spring-2026-mecha11/Course_Proj_Final/docs/doxygen/completed-assembly.png

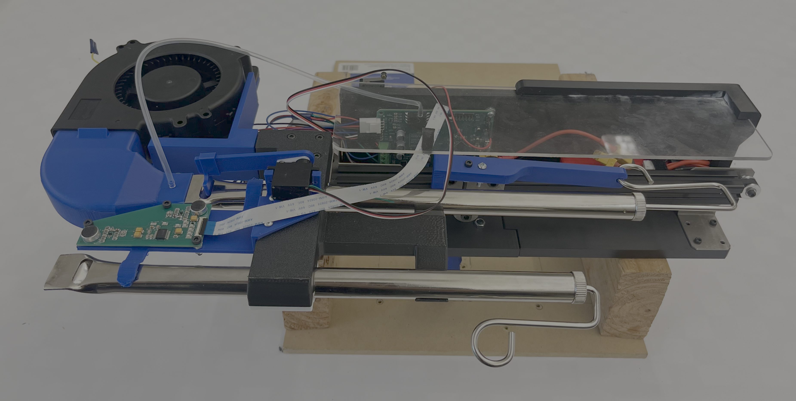
docs/doxygen/completed-assembly.png
