spring-2026-mecha11/Course_Proj_Final/docs/doxygen/main-board-photo.png

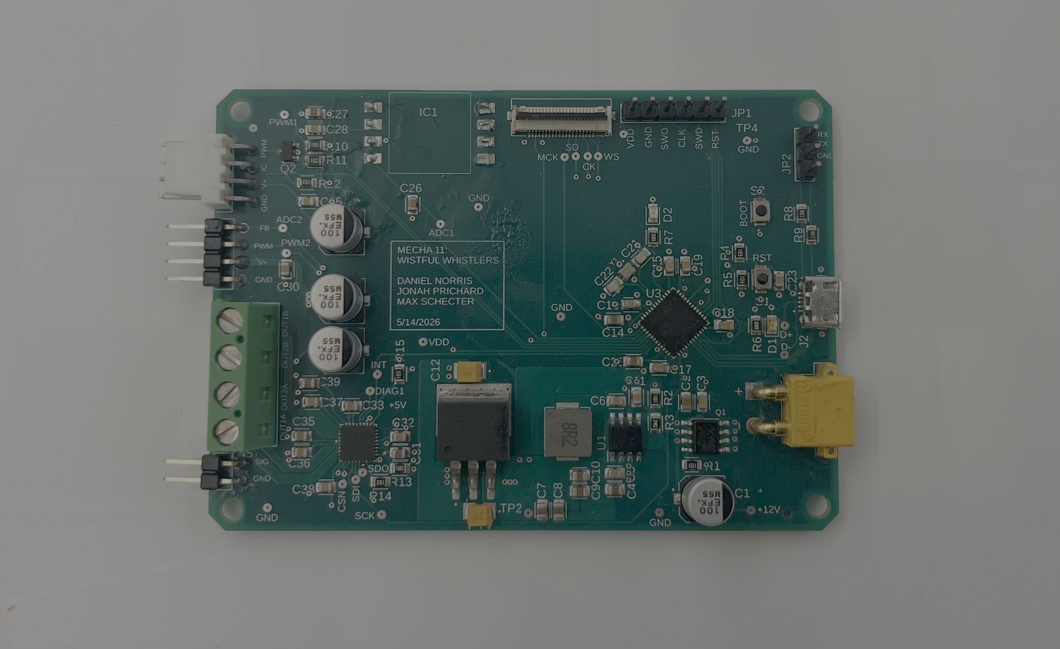
docs/doxygen/main-board-photo.png
