spring-2026-mecha11/Course_Proj_Final/docs/doxygen/audio-board-photo.png

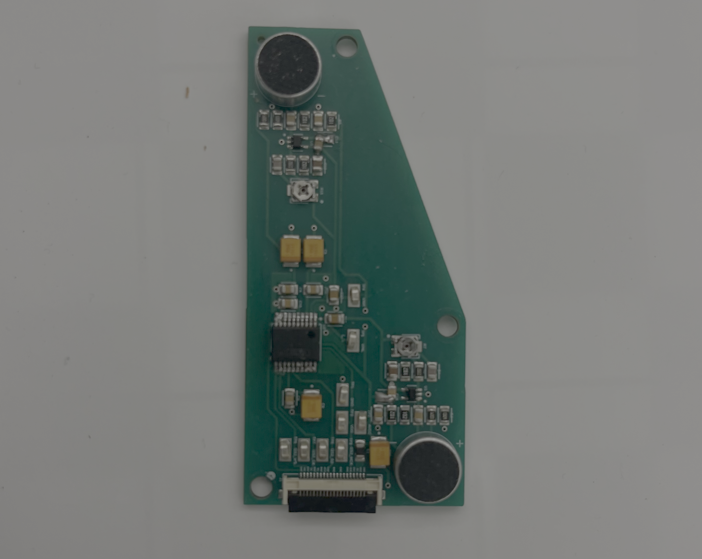
docs/doxygen/audio-board-photo.png
