spring-2026-mecha11/Course_Proj_Final/docs/doxygen/audio-breakout-board.png

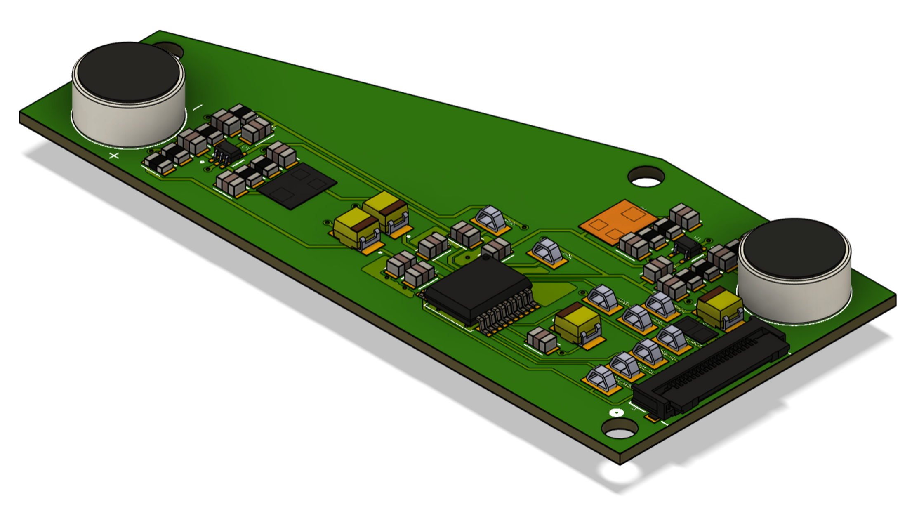
docs/doxygen/audio-breakout-board.png
