spring-2026-mecha11/Course_Proj_Final/docs/doxygen/blower-shroud.png

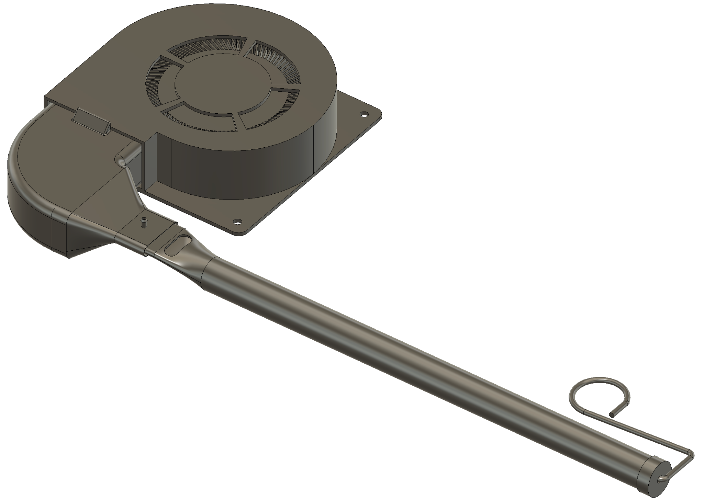
docs/doxygen/blower-shroud.png
