spring-2026-mecha11/Course_Proj_Final/docs/doxygen/final-cad-render.png

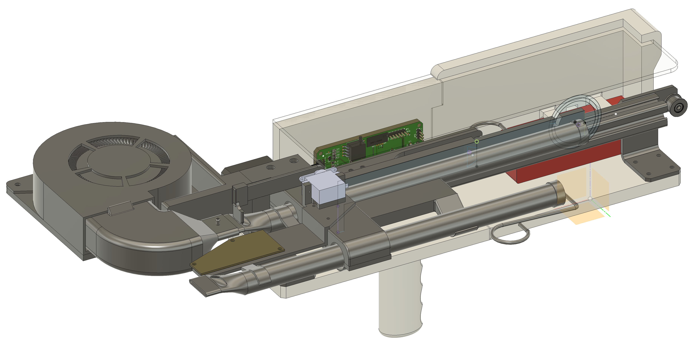
docs/doxygen/final-cad-render.png
