spring-2026-mecha11/Course_Proj_Final/docs/doxygen/servo-stopper.png

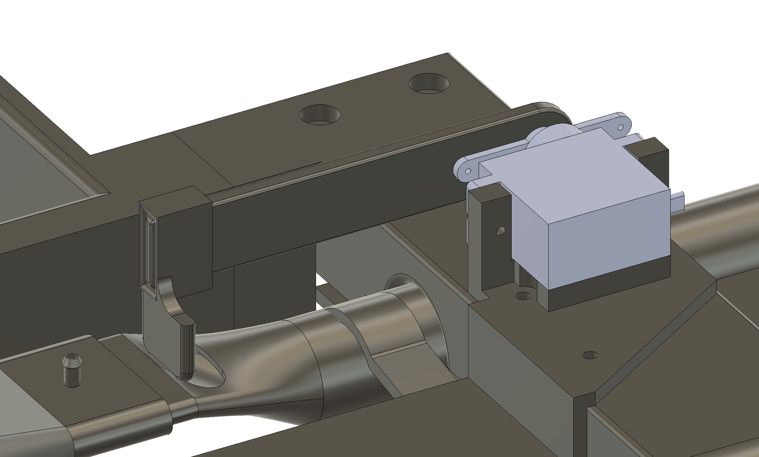
docs/doxygen/servo-stopper.png
