spring-2026-mecha11/Course_Proj_Final/docs/doxygen/slide-mechanism.png

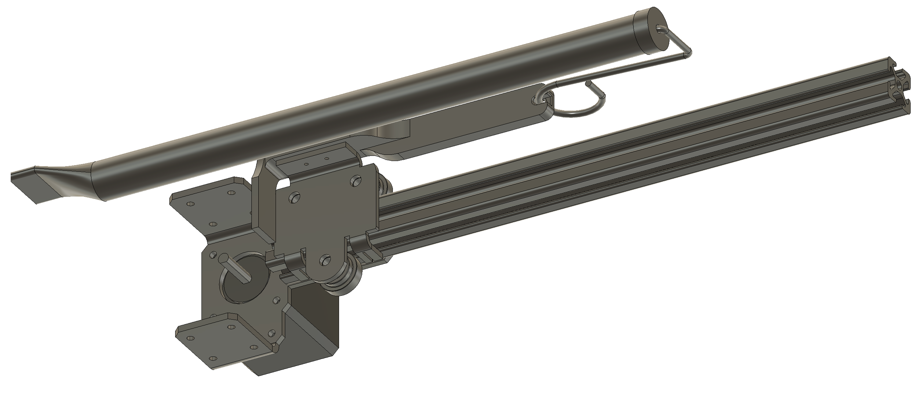
docs/doxygen/slide-mechanism.png
