spring-2026-mecha11/Course_Proj_Final/Course_Proj_Final.ioc

Mcu.UserName=STM32F411CEUx
PA1.Signal=S_TIM2_CH2
PA11.Signal=USB_OTG_FS_DM
PA12.Signal=USB_OTG_FS_DP
PA13.Signal=SYS_JTMS-SWDIO
PA14.Signal=SYS_JTCK-SWCLK
PA2.GPIO_Label=MODE_BTN
PA2.Signal=GPIO_Input
PA3.Signal=I2S2_MCK
PA4.Signal=ADCx_IN4
PA5.GPIO_Label=DRV_ENN
PA5.Signal=GPIO_Output
PA6.Signal=S_TIM3_CH1
PA7.Signal=S_TIM3_CH2
PB0.GPIO_Label=CHIP_SEL
PB0.Signal=GPIO_Output
PB1.GPIO_Label=DIAG_EXTI1
PB1.Signal=GPXTI1
PB10.Signal=I2S2_CK
PB12.Signal=SPI3_SCK
PB15.Signal=I2S2_SD
PB3.Signal=SYS_JTDO-SWO
PB4.Signal=SPI3_MISO
PB5.Signal=SPI3_MOSI
PB9.Signal=I2S2_WS
