spring-2026-mecha11/Course_Proj_Final/Core/Inc/main.h

#define MODE_BTN_Pin GPIO_PIN_2
#define MODE_BTN_GPIO_Port GPIOA
#define DRV_ENN_Pin GPIO_PIN_5
#define DRV_ENN_GPIO_Port GPIOA
#define CHIP_SEL_Pin GPIO_PIN_0
#define CHIP_SEL_GPIO_Port GPIOB
#define DIAG_EXTI1_Pin GPIO_PIN_1
#define DIAG_EXTI1_GPIO_Port GPIOB
