spring-2026-mecha11/Course_Proj_Final/(commit log)

2026-06-11 Added servo drivers
2026-06-11 Second Commit
    Stepper Degub/Cal Mode addded
2026-06-12 Stepper Working!
    Yay
2026-06-12 Fixed bad function call that kept target at 50.
    [State_Machine.c]
